RallyPat/OpenShift/transictrl/docs/legal.md

This project was developed to be a lawful, interoperable, and safe alternative.

- No proprietary code, trade secrets, or confidential materials were used.
- Trademarks are owned by their respective holders. Use here is nominative only.
- Compatibility is achieved via user-provided importers or public documentation.
- Users are responsible for ensuring legal compliance in their jurisdiction.
