RallyPat/OpenShift/pcb/revH/Project Outputs for laatikko/revD.CSV

Bill of Material for
On 19/07/2018 at 13.16.18
Comment | Pattern | Quantity | Components
 | IMAGE | 2 | 1
1.8k | AXIAL-0.3_2 | 8 | R17, R18, R19, R20, R25, R26, R27, R28
100 | AXIAL-0.3_2 | 12 | R34, R44, R52, R60, R76, R77, R80, R82, R83, R86, R89, R95
1000uF | 1000UF PANASONIC | 1 | C9 | EEUFR1E102
100nF | 0.1UF TDK | 5 | C2, C7, C11, C12, C14
10k | AXIAL-0.3_2 | 20 | R1, R2, R3, R4, R5, R6, R7, R8, R38, R47, R55, R63, R78, R81, R84, R87, R90, R91, R93, R96
1k | AXIAL-0.3_2 | 28 | R13, R14, R15, R16, R21, R22, R23, R24, R31, R39, R41, R43, R48, R49, R51, R56, R57, R59, R64, R65, R74, R75, R79, R85, R88, R92, R94, R97
1N4001 | DIODE_DO35 | 12 | D1, D2, D3, D4, D5, D6, D7, D8, D9, D10, D11, D12
1nF | RAD-0.1 | 4 | C3, C4, C5, C6
2ohm | AXIAL-0.3_2 | 1 | R29
330nF | 330NF TDK | 2 | C1, C8
380 | AXIAL-0.3_2 | 8 | R30, R40, R42, R46, R50, R54, R58, R61
4.7kohm | AXIAL-0.3_2 | 4 | R32, R33, R36, R37
4.99k | AXIAL-0.3_2 | 4 | R9, R10, R11, R12
470 | AXIAL-0.3_2 | 12 | R35, R45, R53, R62, R66, R67, R68, R69, R70, R71, R72, R73
4N35SM | DIL6-SMD | 12 | OK1, OK2, OK3, OK4, OK5, OK6, OK7, OK8, OK9, OK10, OK11, OK12
7805 | TO252 | 2 | U1, U4
EXT CONN | HDR-4X1/2.54 | 1 | CANBUS/SERIAL
IRF540N | TO-263-2 | 12 | Q1, Q2, Q3, Q4, Q5, Q6, Q7, Q8, Q9, Q10, Q11, Q12
LED-3MM | LED-3MM/2.54 | 12 | LED1, LED2, LED3, LED4, LED5, LED6, LED7, LED8, LED9, LED10, LED11, LED12
MAX9926UAEE+ | QSOP-16_150MIL | 2 | U2, U3
POWER | HDR-4X1/2.54 | 1 | PWR
Sensor/General INPUT | HDR1X16 | 1 | GENERAL INPUT
Teensy 3.5 | TEENSY 3.5 | 1 | U5
to OLED display | HDR-8X1/2.54 | 1 | Display
VR INPUT1 | HDR-4X1/2.54 | 1 | P7
VR INPUT2 | HDR-4X1/2.54 | 1 | P6
