RallyPat/OpenShift/(commit log)

2026-07-16 feat: complete Rust transictrl port and serial telemetry bridge
    - Add transictrl-core, transictrl-hal, transictrl-722, protocol crates
    - Add RP2350, STM32F4, and Teensy4 firmware crates (latter skeleton)
    - Add host server with axum, WebSocket telemetry, and serial bridge
    - Add egui dataviz app, simulator, and calibration CLI
    - Add Python maps-converter for main/include/maps.h
    - Update READMEs, datalog docs, and add dataviz/README.md
    - Ignore Rust target/ build artifacts
2026-07-20 feat: add revL universal PCB design + closed-loop current & CAN HAL
    revL is a new SMD controller board (RP2350B) that drives any supported
    transmission (4L60E/4L80E, 722.6, 6L80, 4R70W, 8HP, 10-speed) via a superset
    of channels. Bring-up target is the 4L60E. Full spec, BOM, netlist and a
    reference Gerber outline live under pcb/revL/; the existing revH/I/K Gerber
    and BOM outputs are also committed.
    Firmware:
    - transictrl-hal: current_pi (anti-windup PI controller for SolenoidCurrent)
    and can (lock-free SPSC receive ring + ID/mask filter). Both are no_std,
    forbid(unsafe_code), dependency-free and host-tested.
    - fw-rp2350: Mcp3208 reader + RpCurrentSolenoid + current_control_task,
    Mcp251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
